chardur/SmartVentPrototype/Smart-Vents-Presentation.pptx

## Smart-Vents

## Benefits:

- Automatically re-direct airflow to the rooms in your house that need it.
- Increase comfort and save on energy bills
- Control vents in hard to reach places

## How it works: The hardware

- Prototyped 2 vents:
- Vent1: + + +
- Vent2: + + +

Arduino Nano

ESP8266-Wifi

HXT-900

Servo / Step Motor

DS18B20 sensor

28BYJ-48

## The hardware: what we learned

- Servo is easier to implement for a DIY project
- Step motor is more durable/quiet, would be better for a production unit
- Using the ESP8266 wifi module was difficult (steep learning curve)

## How it works: Big picture

- Step 1: Vents send temperature in a php GET request to web server.
- Step 2: Server responds with the vent position.
- Step 3: Vent position is parsed and vent moves accordingly.

## How it works: Server flow-chart

Vent 1

Vent1pos.txt
Vent2pos.txt

Vent2

Vent1.php
Vent1.txt

Thermostat.php

Vent2.php
Vent2.txt

Dashboard.php

VentSettings.php
settingsArray.json

## Challenges:

- ESP8266 module- steep learning curve (trial and error)
- Constant updates- refreshing server with out loosing settings / data on page (used files to store data)
- Learning to program the arduino (youtube tutorials)

## Not enough time:

- More vent settings / options in dashboard
- Direct communication between vents / local server
- Use Ajax to streamline server process
- Integration with home thermostat
- Separate temp sensor from vent
- Cordless / solar power
